florianamoser/splicer/README.md

# Splicer

Splicer is a camera apparatus for visual sampling  
Check <a href="https://documentation.splicer.camera">documentation.splicer.camera</a> for more in-depth information.  

Initial release 23.05.2025
