florianamoser/splicer/documentation/theory-4.md

Splicer emerges as a photographic apparatus conceived not to solve the crisis of photography, but to live within it – materially, decelerated, and critically. As the preceding chapters have argued, photography today is no longer defined by representation, but by computation, circulation, and optimization. Rather than attempting to restore lost indexicality or rival synthetic images in speed or realism, Splicer intervenes otherwise. It performs photography as an act of friction, care, and encounter – exposing the apparatus, slowing down the process, and foregrounding the relations that condition the image. In this way, Splicer is not a nostalgic return to older forms, but a proposal for how to work with and against the post-photographic condition from within.

At the core of Splicer’s intervention is a reconfiguration of the camera as an open, situated, and performative device. Unlike conventional cameras that conceal their internal logic behind polished interfaces and automated presets, Splicer exposes its mechanisms – both literally and conceptually. Its multi-axis motion system, open-source construction, and physical scale render visible the labor, materiality, and choreography behind each image. The machine does not promise frictionless usability or seamless results; instead, it demands presence, calibration, and negotiation. In doing so, Splicer becomes not just a tool for image production, but a space of engagement – between operator and object, time and process, image and infrastructure.

Splicer resists the temporal logic of immediacy that governs much of contemporary visual culture. Each image is constructed over time – line by line, gesture by gesture – through an iterative process that cannot be undone or instantly previewed. This slowness is not a technical limitation, but a methodological choice: it reintroduces consequence into image-making, foregrounding decision, care, and embodied attention. Without the promise of instant capture or automated correction, the photographic act becomes durational and reflective. Splicer thus reframes photography as a temporal commitment – where the image emerges not as a decisive moment, but as an extended negotiation between machine, material, and intent.

The images produced by Splicer are not designed for immediate legibility or platform-ready gloss. They are dense, abstracted, and often ambiguous – layered visual fields that resist quick interpretation. This abstraction is not aesthetic decoration but a strategic refusal: a rejection of the hyperreal clarity and optimized visibility demanded by computational image culture. Instead of offering recognition, Splicer’s images invite resonance. They ask to be dwelled with, not decoded; to be encountered as material traces of process, not as transparent representations.  

Splicer does not position the photographer as a sole author, but as a participant in a distributed act of making. The image emerges through a dialogue between apparatus, operator(s), object, and environment – each shaping the outcome in unpredictable ways. This relational setup dissolves the myth of the autonomous photographer and repositions photographic authorship as shared and situated. As participants bring their own materials, gestures, and inquiries into the process, Splicer becomes a space for co-production and reflection. In this way, it embodies Ariella Azoulay’s vision of photography as a civic and relational practice – one grounded not in ownership or mastery, but in negotiation and encounter `Azoulay, 2015`.

Embedded in Splicer’s design is an ethic of maintenance rather than control. Unlike automated imaging systems that erase every error in pursuit of perfection, Splicer acknowledges fragility, constraint, and failure as part of the image-making process. Its images bear the traces of misalignment, vibrations and unplanned accidents – marks not of dysfunction, but of presence. To work with Splicer is to care for a system in flux: to recalibrate, to adapt, to wait. This ethic of maintenance aligns photography with practices of repair and situated knowledge, where imperfection is not a flaw but a form of attention. Through this, Splicer enacts a shift from photography as capture to photography as care.

More than a device, Splicer functions as a philosophical tool – an apparatus that materializes questions rather than resolving them. It does not aim to define what photography should become after its infrastructural and aesthetic collapse, but rather to keep that question active through practice. Each image it generates is a study, not a product; a trace of process, not a conclusion. In this sense, Splicer offers an open framework for thinking with photography, not just about it. It proposes that in an era of exhausted visual novelty, the value of image-making lies not in representation, but in relation – between machines and bodies, materials and intentions, aesthetics and ethics.

Splicer does not offer a return to photography’s past, nor a technofix for its algorithmic future. Instead, it proposes a third path: photography as an entangled, situated, and ethical act of attention. It resists speed with slowness, clarity with partial opacity, authorship with collaboration. In doing so, it reframes what a camera can be – not a neutral tool or aesthetic interface, but a site of encounter, maintenance, and meaning-making. As such, Splicer is also a node within the networked image: not merely transmitting data, but intervening in the protocols of attention, circulation, and meaning. Splicer reminds us that photography still matters – not for what it shows, but for how it asks us to see, relate, and remain present.
