florianamoser/splicer/documentation/re-documentation.md

This is a fictional email exchange that stages the internal frictions and cross-disciplinary misunderstandings encountered during the development of Splicer. To craft a surreal and somewhat ironic narrative, I have chosen to present each position in the first person and sign all of them with my name. The intention is not to ridicule the disciplines involved, but to highlight the clash between differing perspectives and priorities, ultimately serving as a way to communicate the realities of Splicer's development process.

*Click on images to enlarge*  

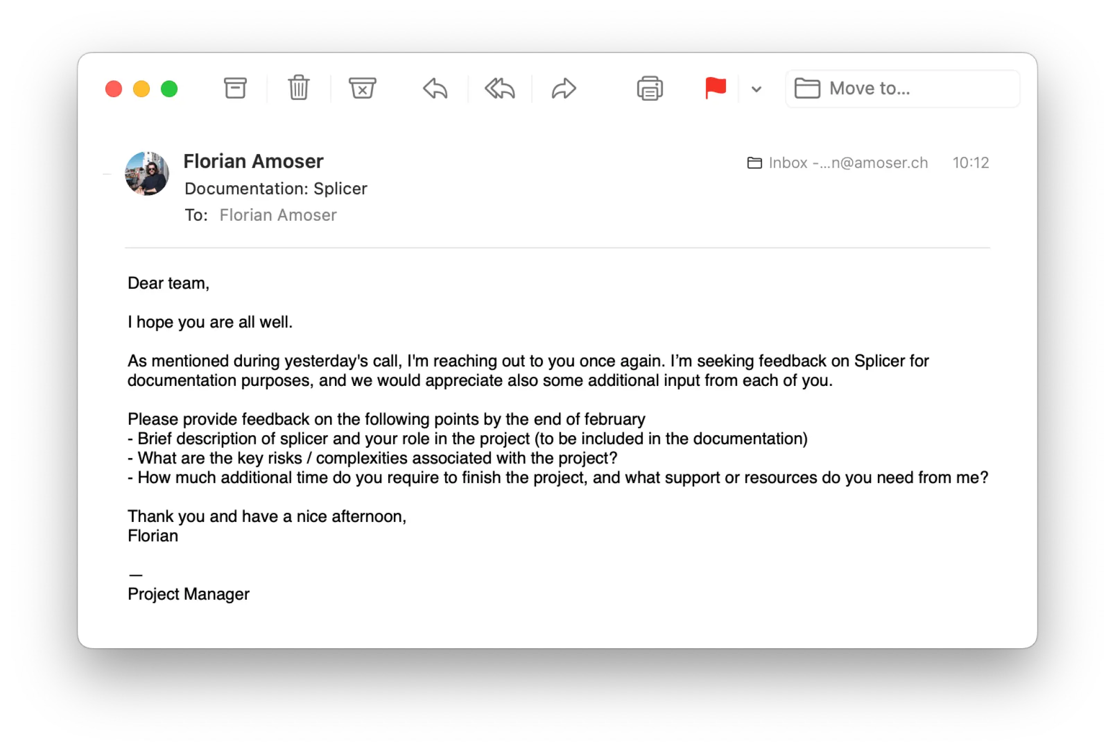
[picture p30: documentation/assets/FlorianAmoser_Splicer_ReDocumentationSplicer-ProjectManager.webp]
Re: Documentation Splicer: Project Manager
  

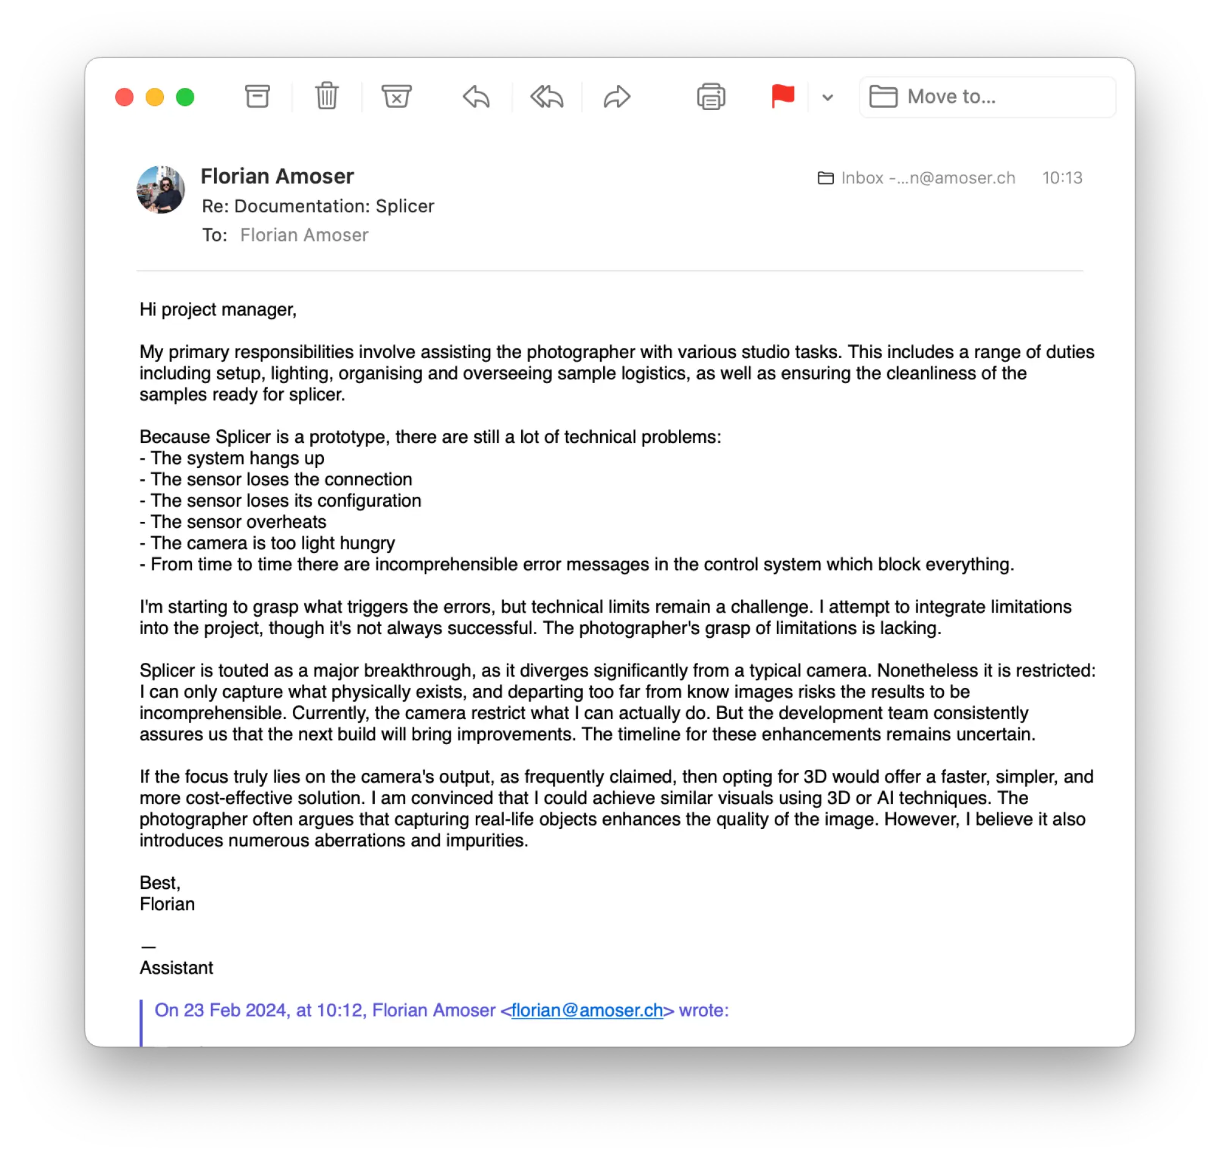
[picture p31: documentation/assets/FlorianAmoser_Splicer_ReDocumentationSplicer-Assistant.webp]
Re: Documentation Splicer: Assistant
  

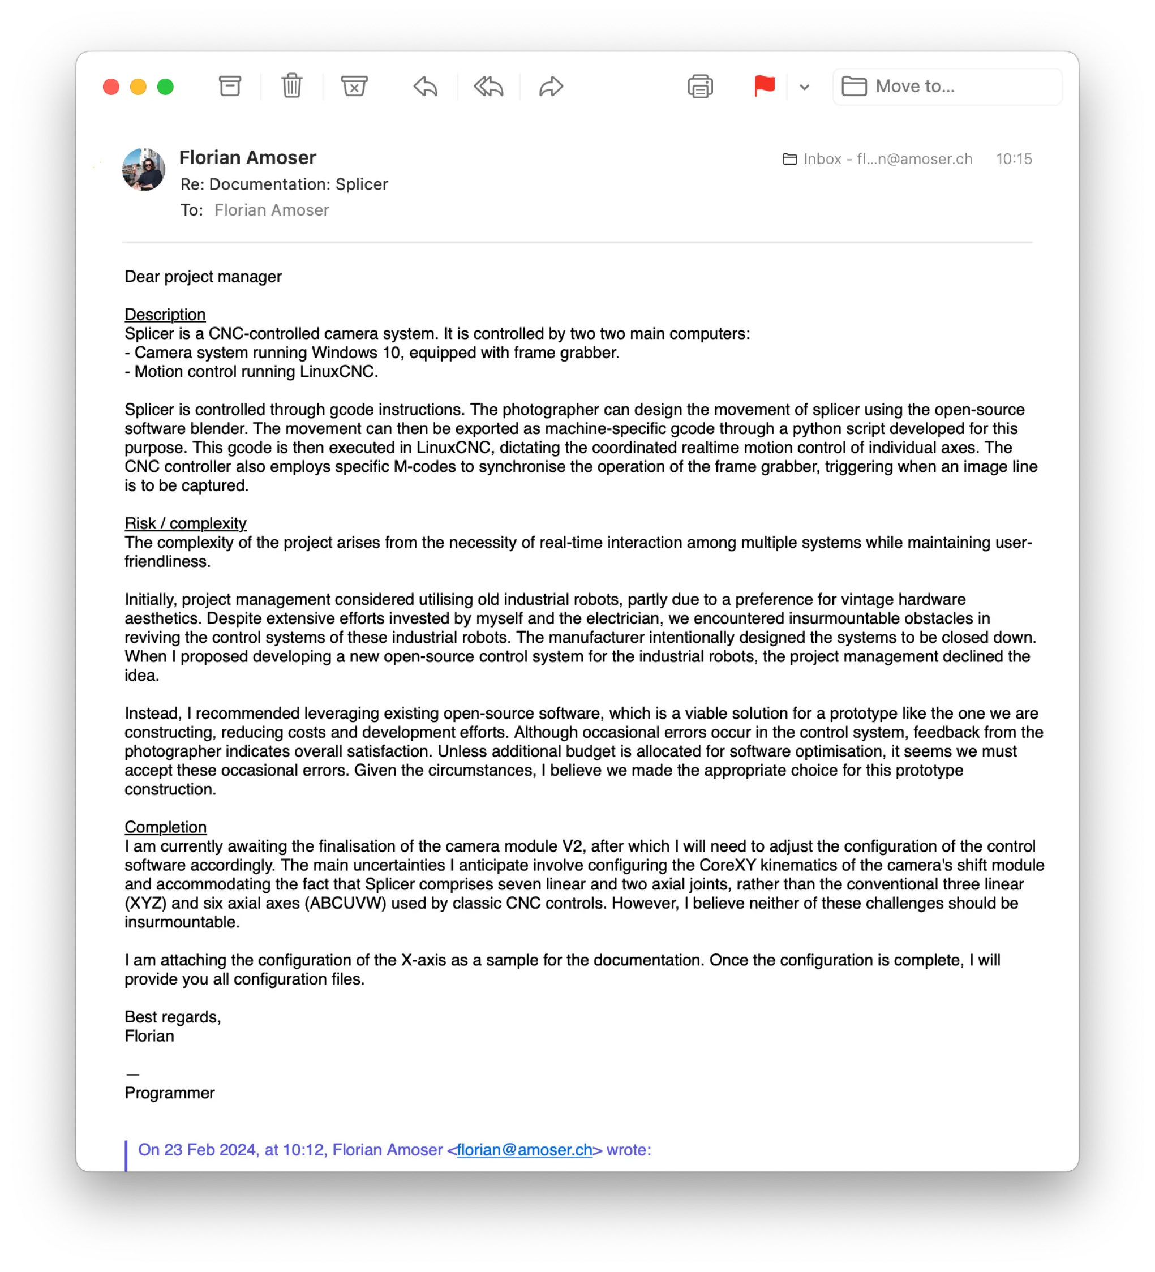
[picture p32: documentation/assets/FlorianAmoser_Splicer_ReDocumentationSplicer-Programmer.webp]
Re: Documentation Splicer: Programmer
  

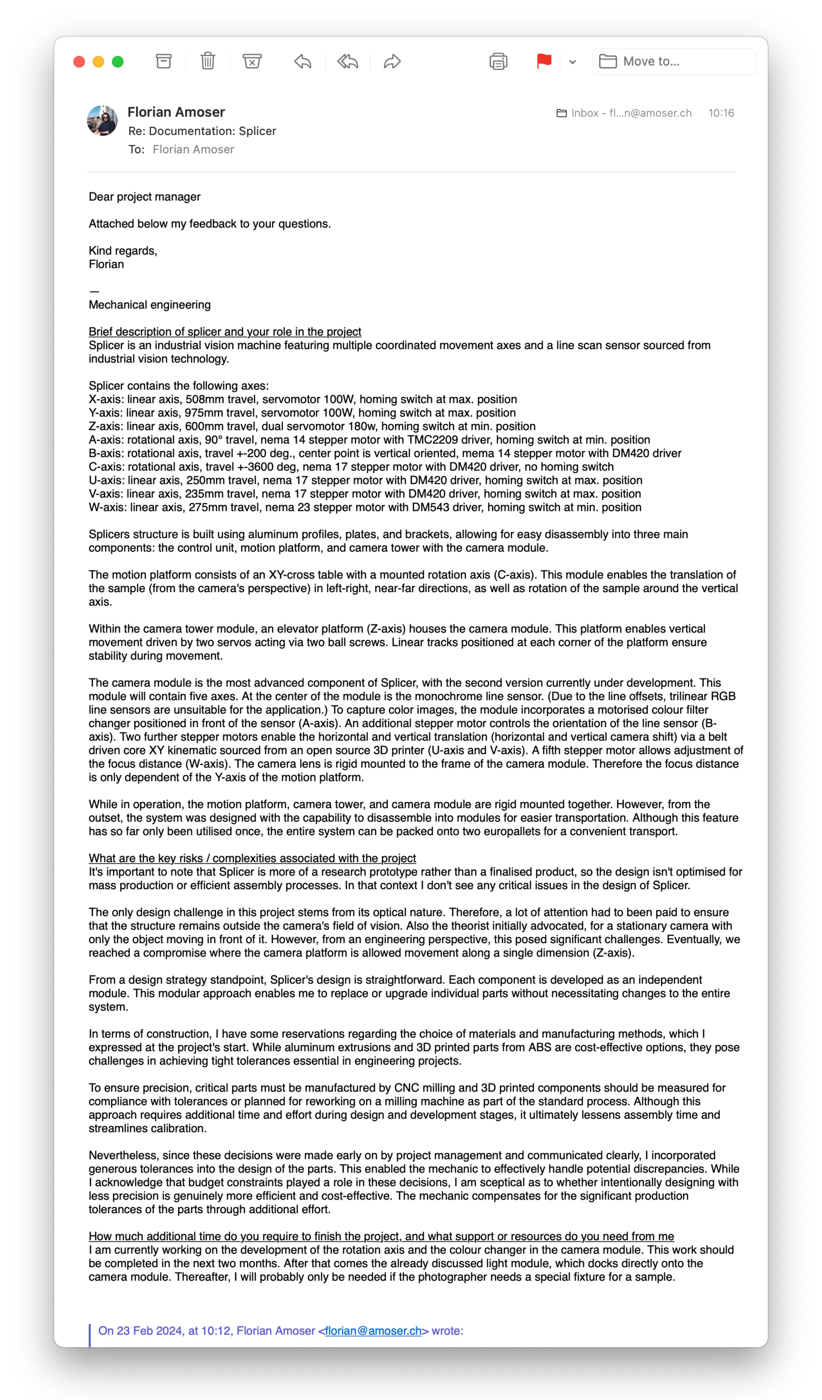
[picture p33: documentation/assets/FlorianAmoser_Splicer_ReDocumentationSplicer-MechanicalEng.webp]
Re: Documentation Splicer: MechanicalEng
  

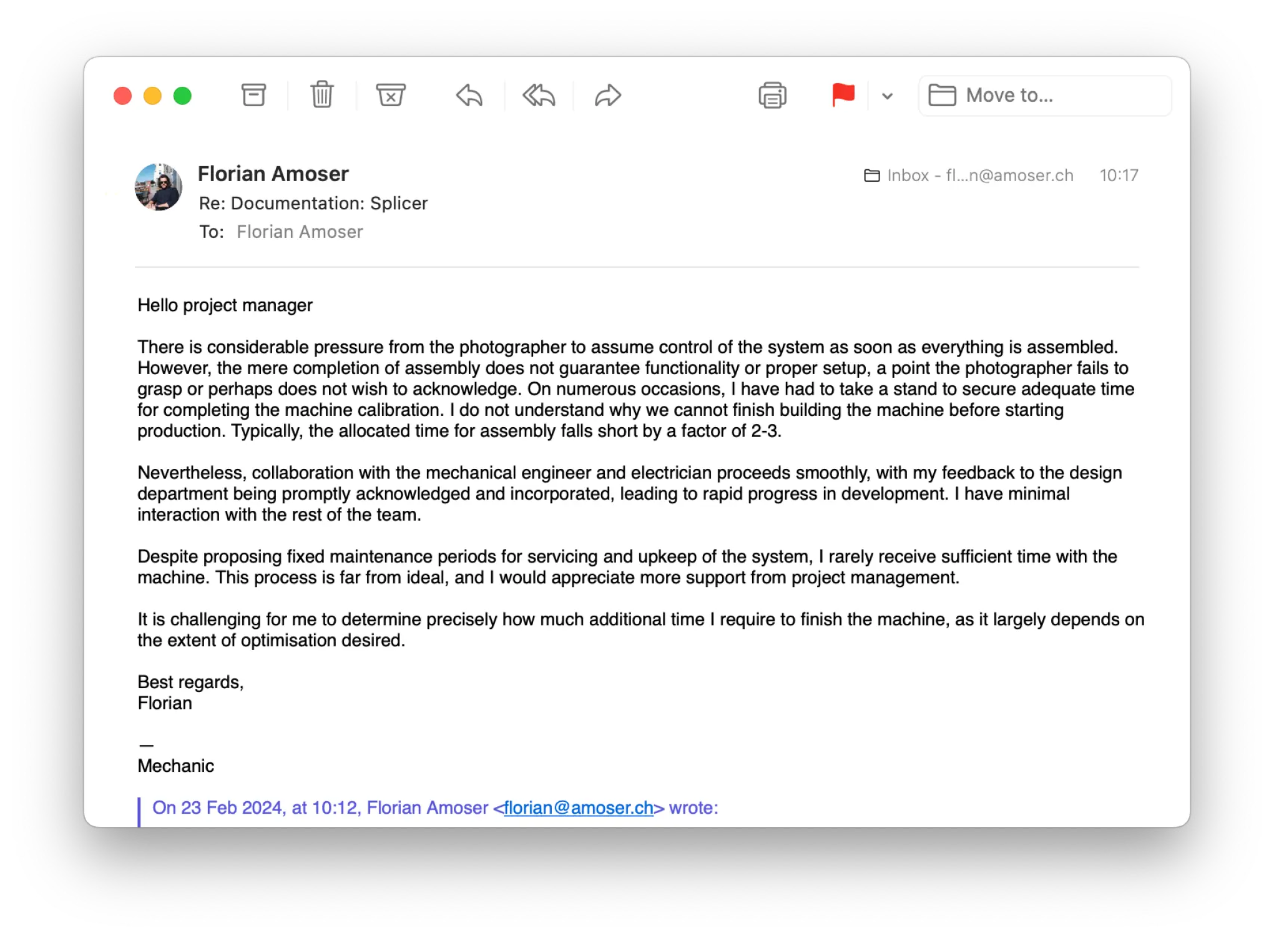
[picture p34: documentation/assets/FlorianAmoser_Splicer_ReDocumentationSplicer-Mechanic.webp]
Re: Documentation Splicer: Mechanic
  

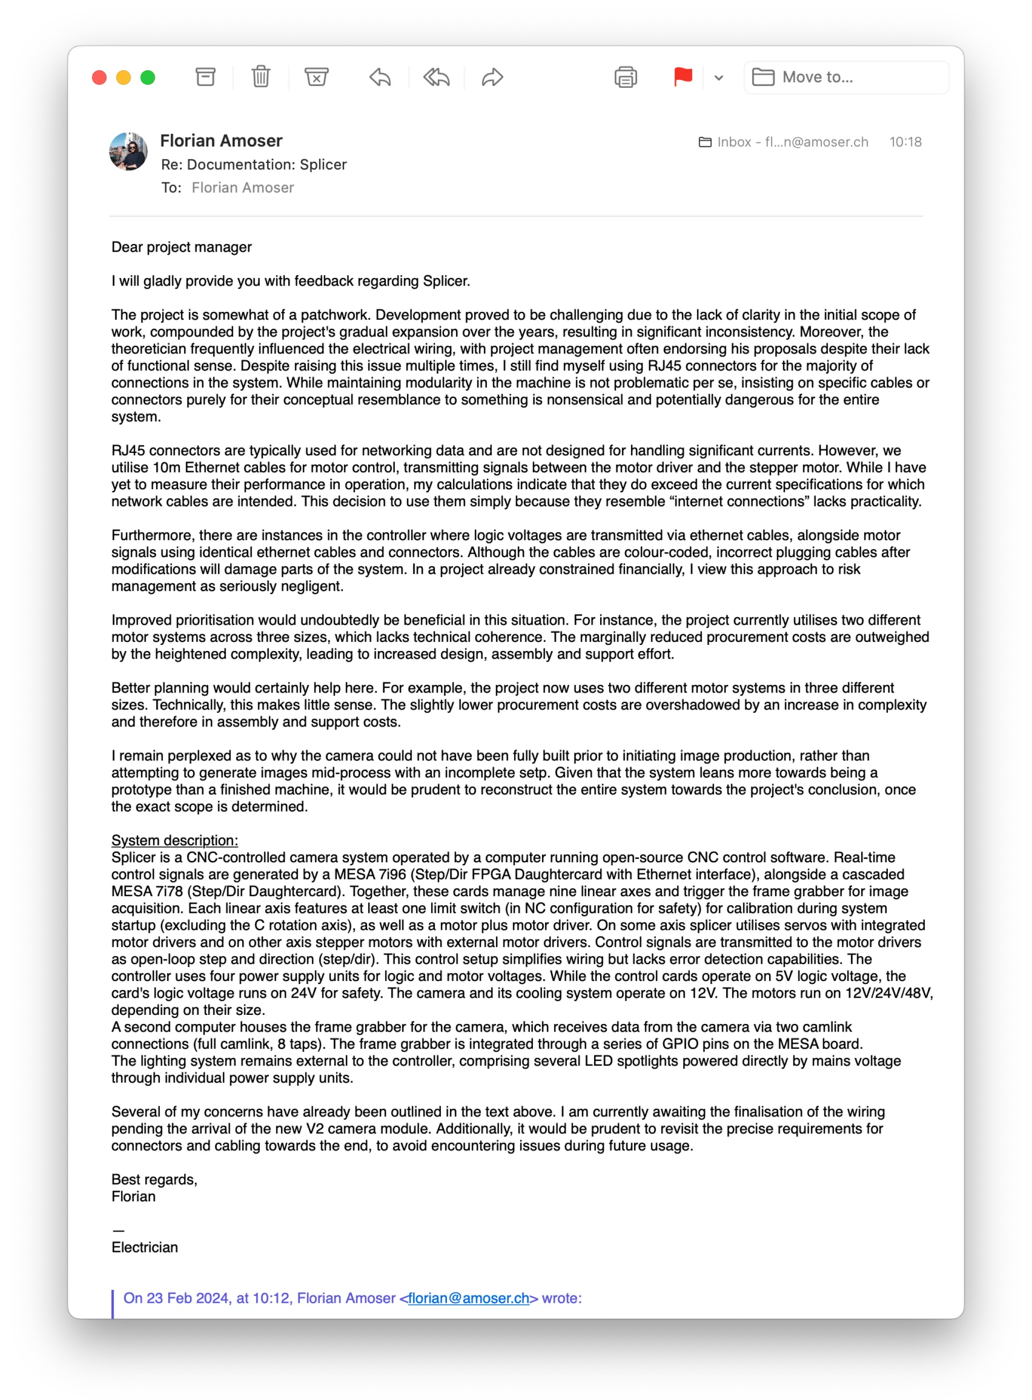
[picture p35: documentation/assets/FlorianAmoser_Splicer_ReDocumentationSplicer-Electrician.webp]
Re: Documentation Splicer: Electrician
  

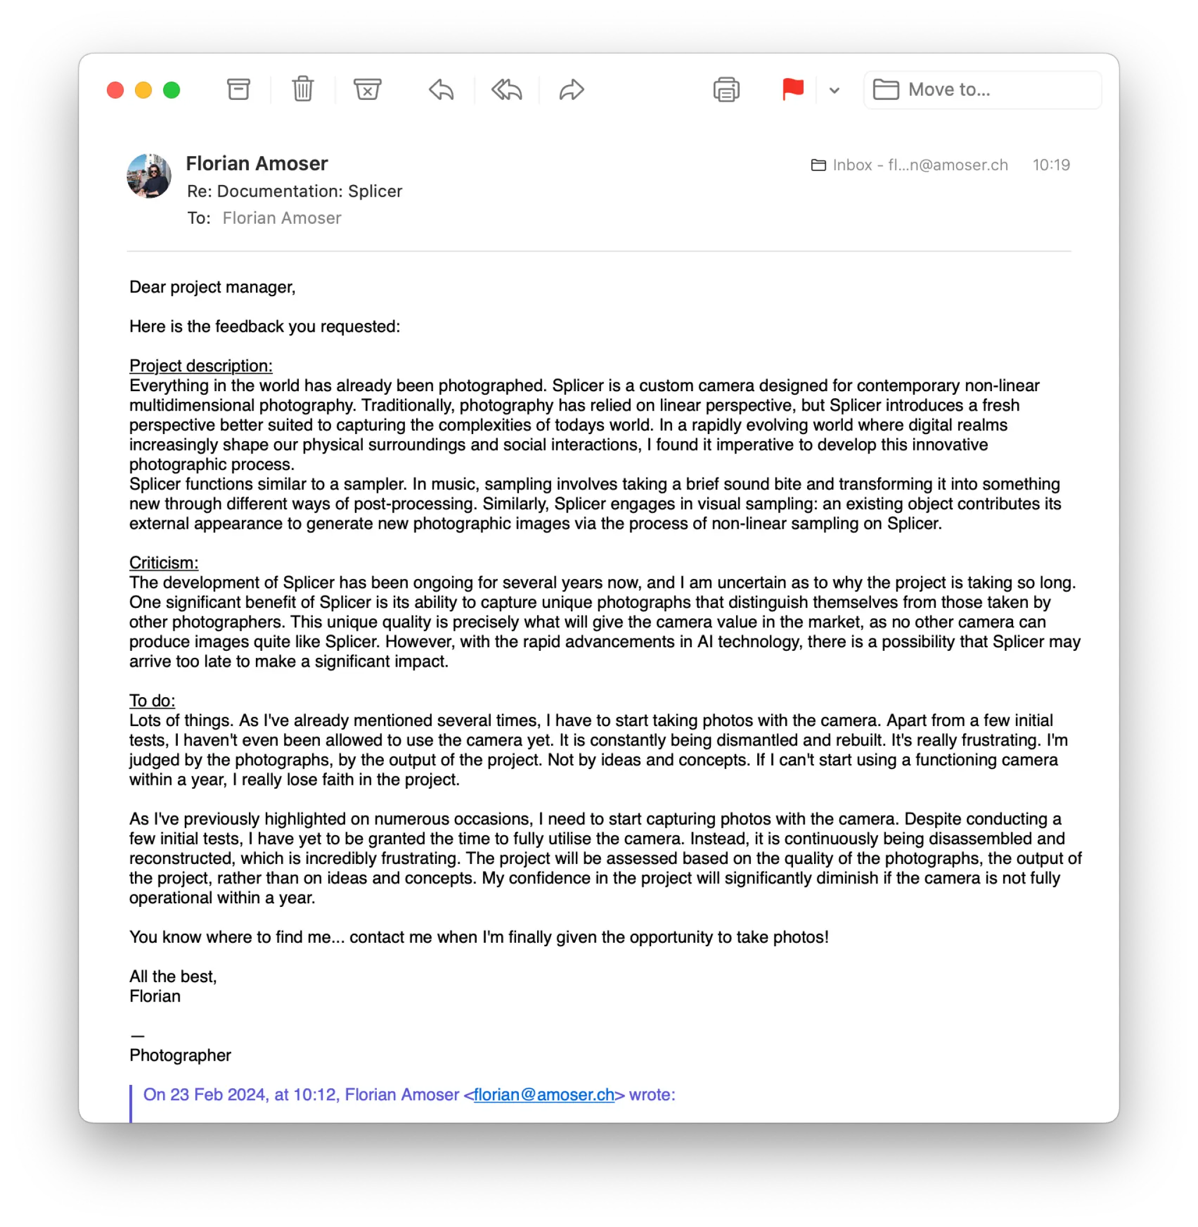
[picture p36: documentation/assets/FlorianAmoser_Splicer_ReDocumentationSplicer-Photographer.webp]
Re: Documentation Splicer: Photographer
  

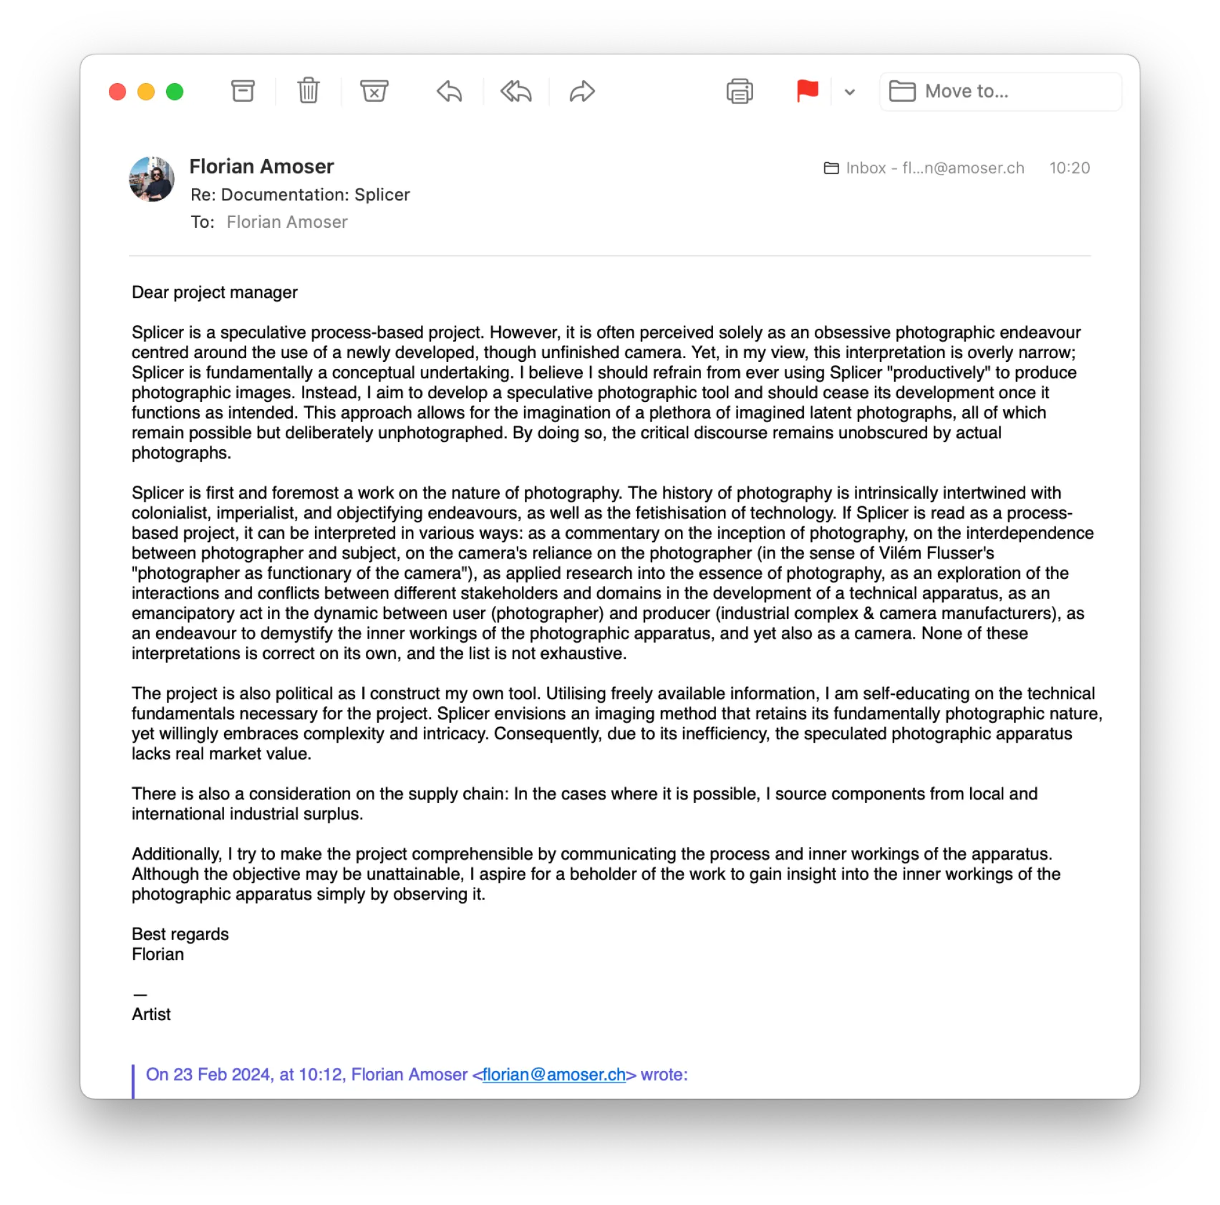
[picture p37: documentation/assets/FlorianAmoser_Splicer_ReDocumentationSplicer-Artist.webp]
Re: Documentation Splicer: Artist
  

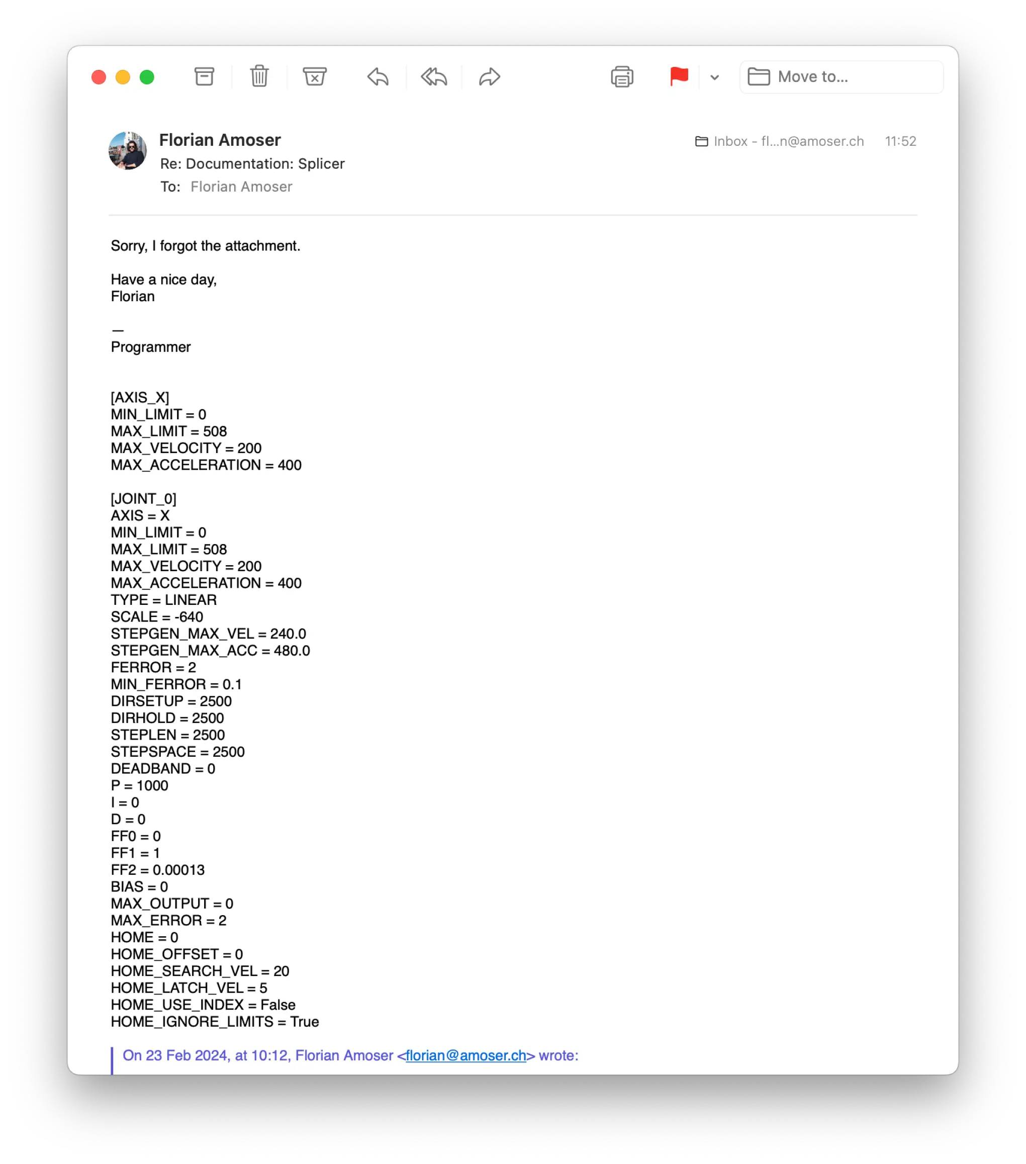
[picture p38: documentation/assets/FlorianAmoser_Splicer_ReDocumentationSplicer-Programmer-2.webp]
Re: Documentation Splicer: Programmer 2
  

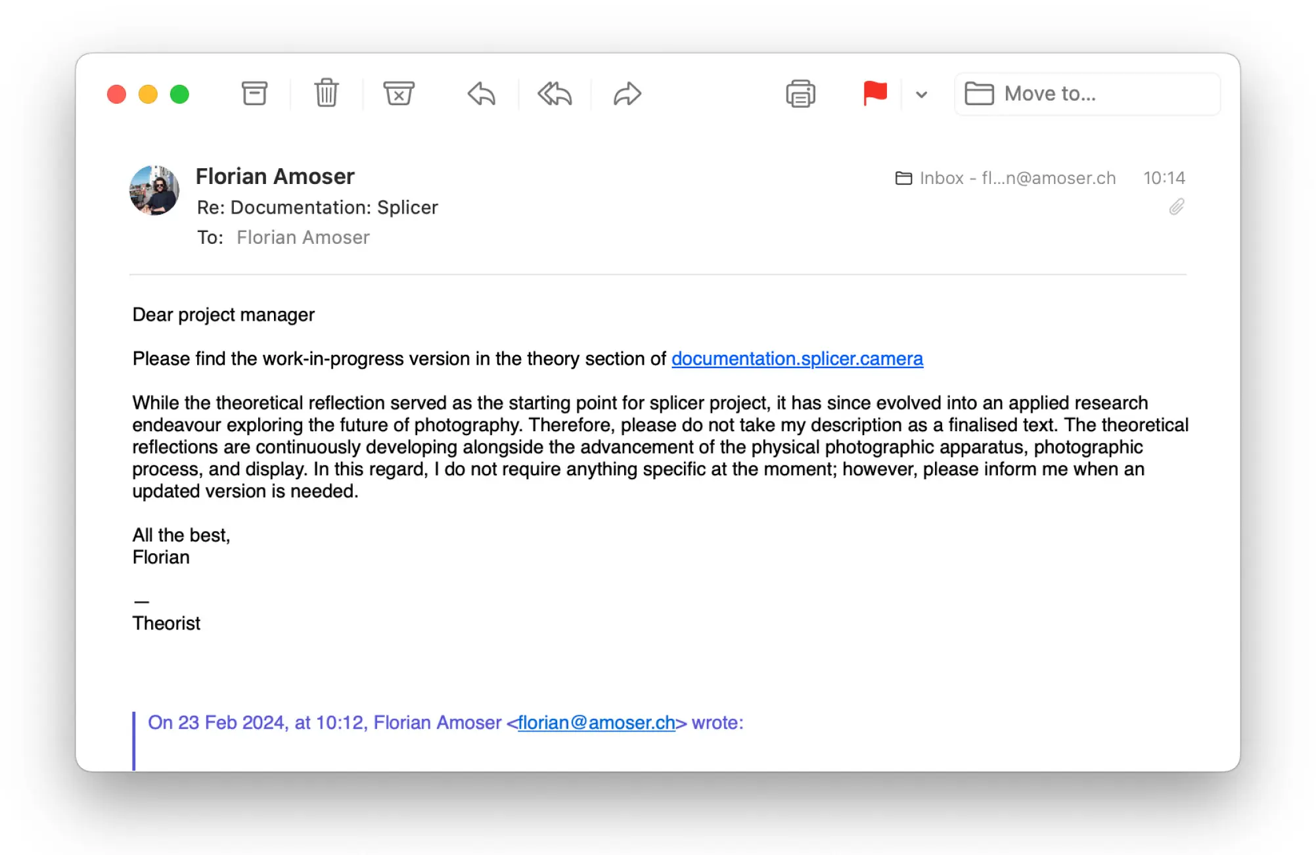
[picture p39: documentation/assets/FlorianAmoser_Splicer_ReDocumentationSplicer-Theorist.webp]
Re: Documentation Splicer: Theorist
