florianamoser/splicer/software/animator/splicer_animator_toolpost_mesh.stl

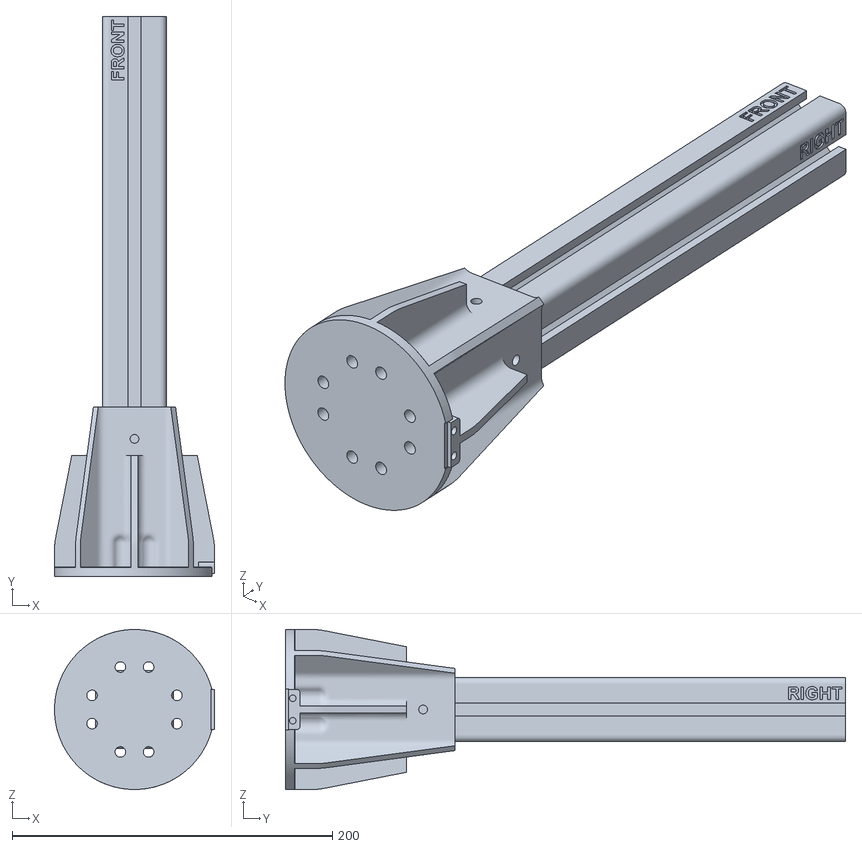
[picture p40: CAD file, 2025-02-14]
software/animator/splicer_animator_toolpost_mesh.stl
100.0 x 350.0 x 100.0
