florianamoser/splicer/(list of files, cad)

Other CAD files:
hardware/cad/splicer_camera/splicer_camera_focus/splicer_camera_focus-rail-gantry-mount_left.f3d
hardware/cad/splicer_camera/splicer_camera_focus/splicer_camera_focus-rail-gantry-mount_right.f3d
hardware/cad/splicer_camera/splicer_camera_focus/splicer_camera_focus_ballscrew-nut.f3d
hardware/cad/splicer_camera/splicer_camera_focus/splicer_camera_focus_ballscrew_fixed-bearing-block_BK10.f3d
hardware/cad/splicer_camera/splicer_camera_focus/splicer_camera_focus_ballscrew_floating-bearing-block_BF10.f3d
hardware/cad/splicer_camera/splicer_camera_focus/splicer_camera_focus_endstop-mount.f3d
hardware/cad/splicer_camera/splicer_camera_focus/splicer_camera_focus_floating-bearing-mount.f3d
hardware/cad/splicer_camera/splicer_camera_focus/splicer_camera_focus_gantry-mount.f3d
hardware/cad/splicer_camera/splicer_camera_focus/splicer_camera_focus_manual-winder-A.f3d
hardware/cad/splicer_camera/splicer_camera_focus/splicer_camera_focus_manual-winder-B.f3d
hardware/cad/splicer_camera/splicer_camera_focus/splicer_camera_focus_motormount-A.f3d
hardware/cad/splicer_camera/splicer_camera_focus/splicer_camera_focus_motormount-B.f3d
hardware/cad/splicer_camera/splicer_camera_focus/splicer_camera_focus_pully-32t.f3d
hardware/cad/splicer_camera/splicer_camera_focus/splicer_camera_focus_rails_MGN9_450mm.f3d
hardware/cad/splicer_camera/splicer_camera_focus/splicer_camera_focus_steppermotor_nema_2356-6.35.f3d
hardware/cad/splicer_camera/splicer_camera_frame/splicer_camera_frame_feet-mount.f3d
hardware/cad/splicer_camera/splicer_camera_frame/splicer_camera_frame_lens-mount.f3d
hardware/cad/splicer_camera/splicer_camera_frame/splicer_camera_frame_lensflange_M65x1.f3d
hardware/cad/splicer_camera/splicer_camera_frame/splicer_extrusion_2020_390mm.f3d
hardware/cad/splicer_camera/splicer_camera_frame/splicer_extrusion_2020_420mm.f3d
hardware/cad/splicer_camera/splicer_camera_frame/splicer_extrusion_2020_460mm.f3d
hardware/cad/splicer_camera/splicer_camera_rgb-filter/splicer_camera_rgb-filter_axle.f3d
hardware/cad/splicer_camera/splicer_camera_rgb-filter/splicer_camera_rgb-filter_bearing-f695.f3d
hardware/cad/splicer_camera/splicer_camera_rgb-filter/splicer_camera_rgb-filter_case-back.f3d
hardware/cad/splicer_camera/splicer_camera_rgb-filter/splicer_camera_rgb-filter_case-front.f3d
hardware/cad/splicer_camera/splicer_camera_rgb-filter/splicer_camera_rgb-filter_filter_B.f3d
hardware/cad/splicer_camera/splicer_camera_rgb-filter/splicer_camera_rgb-filter_filter_G.f3d
hardware/cad/splicer_camera/splicer_camera_rgb-filter/splicer_camera_rgb-filter_filter_R.f3d
hardware/cad/splicer_camera/splicer_camera_rgb-filter/splicer_camera_rgb-filter_gt2-pully-32t-servo-A.f3d
hardware/cad/splicer_camera/splicer_camera_rgb-filter/splicer_camera_rgb-filter_gt2-pully-32t-servo-B.f3d
hardware/cad/splicer_camera/splicer_camera_rgb-filter/splicer_camera_rgb-filter_servo-mount.f3d
hardware/cad/splicer_camera/splicer_camera_rgb-filter/splicer_camera_rgb-filter_wheel.f3d
hardware/cad/splicer_camera/splicer_camera_shift-gantry/splicer_camera_shift-gantry_horizontal-endstop.f3d
hardware/cad/splicer_camera/splicer_camera_shift-gantry/splicer_camera_shift-gantry_round-bubblelevel-mount.f3d
hardware/cad/splicer_camera/splicer_camera_shift-gantry/splicer_camera_shift-gantry_steppermotor_nema_1742-5.f3d
hardware/cad/splicer_camera/splicer_camera_shift-gantry/splicer_camera_shift-gantry_vertical-endstop.f3d
hardware/cad/splicer_camera/splicer_camera_shift-gantry/splicer_camera_shift-gantry_voron-xy_joint_left_lower_MGN12.f3d
hardware/cad/splicer_camera/splicer_camera_shift-gantry/splicer_camera_shift-gantry_voron-xy_joint_left_upper_MGN12.f3d
hardware/cad/splicer_camera/splicer_camera_shift-gantry/splicer_camera_shift-gantry_voron-xy_joint_right_lower_MGN12.f3d
hardware/cad/splicer_camera/splicer_camera_shift-gantry/splicer_camera_shift-gantry_voron-xy_joint_right_upper_MGN12.f3d
hardware/cad/splicer_camera/splicer_camera_shift-gantry/splicer_extrusion_2020_100mm.f3d
hardware/cad/splicer_camera/splicer_camera_shift-gantry/splicer_extrusion_2020_260mm.f3d
hardware/cad/splicer_camera/splicer_camera_shift-gantry/splicer_extrusion_2020_370mm.f3d
hardware/cad/splicer_camera/splicer_camera_shift-gantry/splicer_extrusion_2020_390mm.f3d
hardware/cad/splicer_camera/splicer_camera_shift-gantry/splicer_extrusion_2040_350mm.f3d
hardware/cad/splicer_camera/splicer_camera_toolhead/splicer_camera_toolhead_MGN12H_carriage.f3d
hardware/cad/splicer_camera/splicer_camera_toolhead/splicer_camera_toolhead_bearing-mount-backside_L.f3d
hardware/cad/splicer_camera/splicer_camera_toolhead/splicer_camera_toolhead_bearing-mount-backside_R.f3d
hardware/cad/splicer_camera/splicer_camera_toolhead/splicer_camera_toolhead_bearing-mount-frontside_L.f3d
hardware/cad/splicer_camera/splicer_camera_toolhead/splicer_camera_toolhead_bearing-mount-frontside_R.f3d
hardware/cad/splicer_camera/splicer_camera_toolhead/splicer_camera_toolhead_bellow-board-back-cover.f3d
hardware/cad/splicer_camera/splicer_camera_toolhead/splicer_camera_toolhead_bellow-board-back.f3d
hardware/cad/splicer_camera/splicer_camera_toolhead/splicer_camera_toolhead_bellow-board-front.f3d
hardware/cad/splicer_camera/splicer_camera_toolhead/splicer_camera_toolhead_carriage.f3d
hardware/cad/splicer_camera/splicer_camera_toolhead/splicer_camera_toolhead_carriage_beltclamp.f3d
hardware/cad/splicer_camera/splicer_camera_toolhead/splicer_camera_toolhead_fan-MF50152VX.f3d
hardware/cad/splicer_camera/splicer_camera_toolhead/splicer_camera_toolhead_fan-left-flap.f3d
hardware/cad/splicer_camera/splicer_camera_toolhead/splicer_camera_toolhead_fan-left-mount.f3d
hardware/cad/splicer_camera/splicer_camera_toolhead/splicer_camera_toolhead_fan-right-flap.f3d
hardware/cad/splicer_camera/splicer_camera_toolhead/splicer_camera_toolhead_fan-right-mount.f3d
hardware/cad/splicer_camera/splicer_camera_toolhead/splicer_camera_toolhead_sensor-carriage-back.f3d
hardware/cad/splicer_camera/splicer_camera_toolhead/splicer_camera_toolhead_sensor-carriage-bearingring-back.f3d
hardware/cad/splicer_camera/splicer_camera_toolhead/splicer_camera_toolhead_sensor-carriage-bearingring-front.f3d
hardware/cad/splicer_camera/splicer_camera_toolhead/splicer_camera_toolhead_sensor-carriage-front.f3d
hardware/cad/splicer_camera/splicer_camera_toolhead/splicer_camera_toolhead_sensor-mockup.f3d
hardware/cad/splicer_camera/splicer_camera_toolhead/splicer_camera_toolhead_sensor-rotation-bearing_SKF_61816-2RS.f3d
hardware/cad/splicer_camera/splicer_camera_toolhead/splicer_camera_toolhead_sensor-rotation-motor-mount.f3d
hardware/cad/splicer_camera/splicer_camera_toolhead/splicer_camera_toolhead_sensor-rotation-motor-nema14.f3d
hardware/cad/splicer_camera/splicer_camera_toolhead/splicer_extrusion_2020_100mm.f3d
hardware/cad/splicer_camera/splicer_camera_toolhead/splicer_extrusion_2020_152.7mm.f3d
hardware/cad/splicer_camera/splicer_camera_toolhead/splicer_extrusion_2020_159.6mm.f3d
hardware/cad/splicer_controller/splicer_RJ45BOB_2020-mount.f3d
hardware/cad/splicer_controller/splicer_control_folding-table-mdf-16mm.f3d
hardware/cad/splicer_controller/splicer_controller-5xRJ45BOB-mount_dinrail.f3d
hardware/cad/splicer_controller/splicer_controller_4040_48v_wago-mount.f3d
hardware/cad/splicer_controller/splicer_controller_48v_psu_mount4040.f3d
hardware/cad/splicer_controller/splicer_controller_RJ45BOB_4040-mount.f3d
hardware/cad/splicer_controller/splicer_controller_Z-axis_RJ45BOB_JMC-mount-duo.f3d
hardware/cad/splicer_controller/splicer_controller_dinrail-4xDM420-1x542-mount.f3d
hardware/cad/splicer_controller/splicer_controller_display-4040-vesa-mount_A.f3d
hardware/cad/splicer_controller/splicer_controller_display-4040-vesa-mount_B.f3d
hardware/cad/splicer_controller/splicer_controller_emergency-switch-box.f3d
hardware/cad/splicer_controller/splicer_controller_endstop_D2F.f3d
hardware/cad/splicer_controller/splicer_controller_kvm-button-case-bottom.f3d
hardware/cad/splicer_controller/splicer_controller_kvm-button-case-top.f3d
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
