florianamoser/splicer/documentation/building-packages.md

<figure markdown="1">
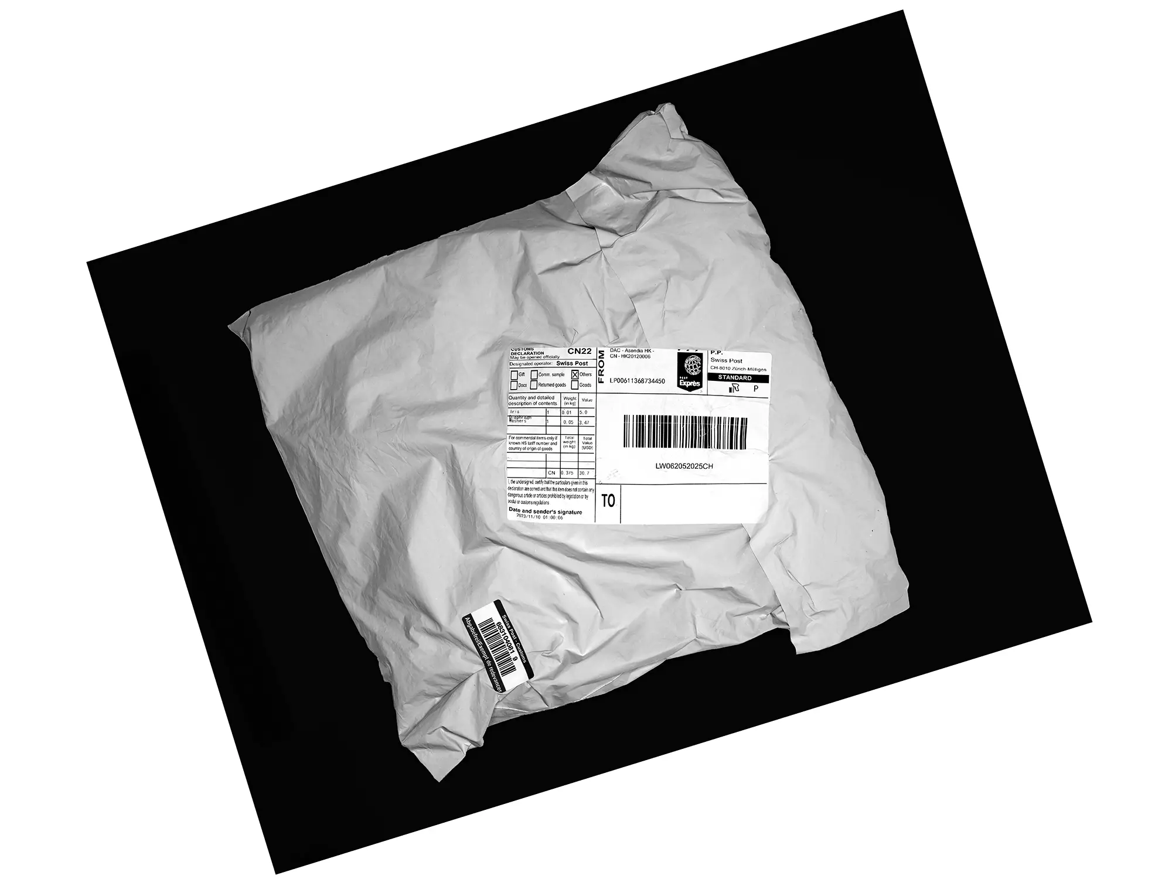
[picture p47: documentation/assets/FlorianAmoser_Splicer_SupplychainPackages.webp]
24 packages

</figure>

```
SPLICER / SUPPLY CHAIN, February 2024
Laser print on recycled A4 paper, black and white, cross-polarized photography

An inventory of the invisible infrastructures behind artistic tools, 
Splicer / Supply Chain documents 24 packages received in February 2024 
from AliExpress during the construction of Splicer. Shot in the aesthetic 
logic of automated postal sorting systems, the cross-polarized photographs 
document the flow of global distribution and the supply chain dependencies 
embedded in creative production.
```
