florianamoser/splicer/documentation/external-manuals.md

Following is a list of manuals for software and hardware used in the development of Splicer. These resources were essential in building, calibrating, and debugging various components of the apparatus.

---

### Manual: Camera Sensor  
<a href="https://www.manualslib.com/manual/2720050/Teledyne-Dalsa-Piranha-2-P2-2x-40-Series.html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" target="_blank" rel="noopener noreferrer">
Teledyne Dalsa Piranha 2 P2-2x-08K40</a>

### Manual: Frame Grabber Software (Sapera LT)  
<a href="https://ftp.stemmer-imaging.com/webdavs/docmanager/164129-SaperaLT-User-Manual-V8.6.pdf" target="_blank" rel="noopener noreferrer">
Sapera LT User Manual (v8.6)</a>

### Datasheet: Schneider-Kreuznach Componon-S 80mm Lens  
<a href="https://ftp.stemmer-imaging.com/webdavs/docmanager/141088-Schneider-Componon-S-12-80-4.0.pdf" target="_blank" rel="noopener noreferrer">
Schneider Componon-S 80mm f/4.0</a>

---

### Documentation: LinuxCNC  
<a href="https://linuxcnc.org/docs/stable/html/" target="_blank" rel="noopener noreferrer">
LinuxCNC Stable Documentation</a>

### Manual: Mesa Motion Control Interface 
<a href="https://www.mesanet.com/pdf/parallel/7i96man.pdf" target="_blank" rel="noopener noreferrer">
Mesa 7i96 Step/Dir Motion Control Interface</a>

### Manual: Mesa Motion Control Interface  
<a href="https://www.mesanet.com/pdf/parallel/7i78man.pdf" target="_blank" rel="noopener noreferrer">
Mesa 7i78 Step/Dir Plus I/O Daughtercard</a>

### HAL Config: LinuxCNC CoreXY with Mesa 7i96  
<a href="https://github.com/antonchromjak/corexy_by_hal-with-mesa-7i96-config" target="_blank" rel="noopener noreferrer">
CoreXY by HAL with Mesa 7i96 (GitHub)</a>

---

### Documentation: Blender  
<a href="https://docs.blender.org/manual/en/latest/" target="_blank" rel="noopener noreferrer">
Blender User Manual (latest)</a>

### API Documentation: Blender Python  
<a href="https://docs.blender.org/api/current/" target="_blank" rel="noopener noreferrer">
Blender Python API</a>
