florianamoser/splicer/documentation/abstract/changelog.md

|Date| Change|
|---|---|
|**23.05.2025**| initial release of documentation.camera.splicer |
