florianamoser/splicer/software/linux-cnc-config/custom.hal

# Place any HAL commands in this file that you want to run before the GUI.
# This file will not be written over by the configuration tool.

net frametrigger hm2_7i96.0.ssr.00.out-00
net filterA hm2_7i96.0.ssr.00.out-02
net filterB hm2_7i96.0.ssr.00.out-03
#net linetrigger hm2_7i96.0.ssr.00.out-01 #possibly not needed as lines are triggered via M63 M64 code and not M101
