florianamoser/splicer/(commit log)

2025-01-20 initial commit of cad components
    all cad components exported january 2025, camera is still missing in these exports.
    [splicer-Z-axis_rail-mount-link.f3d, splicer-Z-axis_rail-mount-offset.f3d, splicer_4040-corner-bracket.f3d, splicer_8080-corner-bracket.f3d, splicer_8080-endcap.f3d, splicer_8080_m12-mounting-plate.f3d, splicer_RJ45BOB_2020-mount.f3d, splicer_RJ45BOB_negative.f3d]
2025-01-21 update mk docs
    [splicer_C-axis_PX110-100.f3d, splicer_XYC-axis_drag-chain-shelf.stl, splicer_extrusion_4080_520mm.f3d, splicer_extrusion_4080_540mm.f3d]
2025-01-28 initial add of machine config for linux cnc
    9 joints controlling 8 axis, running on linuxcnc 2.9 on rpi, mesa 7i96 and 7i78, Z is two synced motors and A and B are in CoreXY config.
    [corexy_by_hal.hal, custom.hal, io.hal, postgui.hal, splicer.hal]
2025-01-31 add M codes for RGB Filter
    M110 / M111 / M112 / M113
    [custom.hal]
2025-01-31 add cad files
    [splicer_camera_round-bubblelevel-mount.f3d, splicer_control_folding-table-mdf-16mm.f3d, splicer_rotation-C_axis_mount.f3d]
2025-01-31 export of cad models of camera module
    [splicer_camera_RGB-filter-gt2_pully_32t_servo-A.f3d, splicer_camera_RGB-filter-gt2_pully_32t_servo-B.f3d, splicer_camera_focus-ballscrew-pully-32t.f3d, splicer_camera_focus-ballscrew_fixed-bearing-block_BK10.f3d, splicer_camera_focus-ballscrew_floating-bearing-block_BF10.f3d, splicer_camera_focusrails_MGN9_450mm.f3d, splicer_camera_round-bubblelevel-mount.f3d, splicer_camera_sensor-mockup.f3d]
2025-02-01 update cad files
    [splicer_Z-axis_lift-cameras-mount.f3d, splicer_camera_focus-rail-gantry-mount_left.f3d, splicer_camera_focus-rail-gantry-mount_right.f3d, splicer_camera_focus_ballscrew_fixed-bearing-block_BK10.f3d, splicer_camera_focus_ballscrew_floating-bearing-block_BF10.f3d, splicer_camera_focus_endstop-mount.f3d, splicer_camera_focus_floating-bearing-mount.f3d, splicer_camera_focus_gantry-mount.f3d]
2025-02-03 upload toolhead cad files
    [splicer_camera_toolhead_MGN12H_carriage.f3d, splicer_camera_toolhead_bearing-mount-backside_L.f3d, splicer_camera_toolhead_bearing-mount-backside_R.f3d, splicer_camera_toolhead_bearing-mount-frontside_L.f3d, splicer_camera_toolhead_bearing-mount-frontside_R.f3d, splicer_camera_toolhead_bellow-board-back-cover.f3d, splicer_camera_toolhead_bellow-board-back.f3d, splicer_camera_toolhead_carriage.f3d]
2025-02-03 add rgb-filter cad files
    [splicer_camera_rgb-filter_axle.f3d, splicer_camera_rgb-filter_bearing-f695.f3d, splicer_camera_rgb-filter_case-back.f3d, splicer_camera_rgb-filter_case-front.f3d, splicer_camera_rgb-filter_filter_B.f3d, splicer_camera_rgb-filter_filter_G.f3d, splicer_camera_rgb-filter_filter_R.f3d, splicer_camera_rgb-filter_gt2-pully-32t-servo-A.f3d]
2025-02-06 added to cad
    [io.hal, splicer_XYC-axis_TRB20UU-2mm-offset.f3d, splicer_XYC-axis_drag-chain-shelf.stl, splicer_camera_shift-gantry_horizontal-endstop.f3d, splicer_camera_shift-gantry_vertical-endstop.f3d, splicer_camera_shift-gantry_voron-xy_joint_left_lower_MGN12.f3d, splicer_camera_shift-gantry_voron-xy_joint_left_upper_MGN12.f3d, splicer_camera_shift-gantry_voron-xy_joint_right_lower_MGN12.f3d]
2025-02-06 added screws cad files
    [M3_washer.f3d, M3x10 SHCS.f3d, M3x12 SHCS.f3d, M3x14 SHCS.f3d, M3x16 SHCS.f3d, M3x18 SHCS.f3d, M3x20 SHCS.f3d, M3x22 SHCS.f3d]
2025-02-14 update of folder structure and update of splicer animator blender script to all axis
    [splicer_animator_toolpost_mesh.stl, splicer_animator_v2025.blend]
2025-02-14 update splicer camera rgb filter servo mount
    [splicer_camera_rgb-filter_servo-mount.f3d]
2025-02-14 Update custom.hal
    switch pin numbers on RGB Filter
    [custom.hal]
2025-02-14 Update splicer_animator_v2025.blend
    all axis integrated
    [splicer_animator_v2025.blend]
2025-02-20 Update splicer_animator_v2025.blend
    change of c rotation direction
    [splicer_animator_v2025.blend]
2025-02-20 folder rename from machine to hardware
    [M3_washer.f3d, M3x10 SHCS.f3d, M3x12 SHCS.f3d, M3x14 SHCS.f3d, M3x16 SHCS.f3d, M3x18 SHCS.f3d, M3x20 SHCS.f3d, M3x22 SHCS.f3d]
2025-02-24 Update splicer_animator_v2025.blend
    now fixed so that the C axis rotates the right way in the animator, in the blender 3D preview and on splicer.
    [splicer_animator_v2025.blend]
2025-02-24 backup splicer linuxcnc config 250224
    [corexy_by_hal.hal, custom.hal, io.hal]
2025-02-24 adding frame grabber configuration files
2025-04-15 added images to animator
    [splicer_animator_v2025.blend]
2025-04-18 add color filter
2025-05-14 switch off pdf export ci.yml
2025-05-15 switch on pdf export
2025-05-15 switch off pdf
2025-05-15 add print version info
2025-05-19 add acs splicer breakoutboard
    [PCBWay_bom.csv, PCBWay_positions.csv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]
2025-05-19 add sample fixtures
    [splicer_sample-fixation_001.f3d, splicer_sample-fixation_002.f3d, splicer_sample-fixation_003.f3d, splicer_sample-fixation_004.f3d, splicer_sample-fixation_005.f3d, splicer_sample-fixation_006.f3d, splicer_sample-fixation_007.f3d, splicer_sample-fixation_008.f3d]
2025-05-21 add wiring
2025-05-22 add camera module
